distantForest/time_scheduler/documentation/ARCHITECTURE.tmp.md

# COMPONENT ARCHITECTURE

The **Time Scheduler** component manages the execution of functions according to a predefined time schedule. The component's functionality is shown in [Figure 1](#rec-spec-figure_1).

<!-- <div style="float:center" markdown="1"> -->

<!--  -->

<!-- |![](./media/functional-diagram.png "Time scheduler functional diagram")| -->
<!-- |---| -->
<!-- |*Figure 1. Time scheduler functional diagram.*| -->

<!-- </div> -->

  <a name="rec-spec-figure_1">
 <figure>
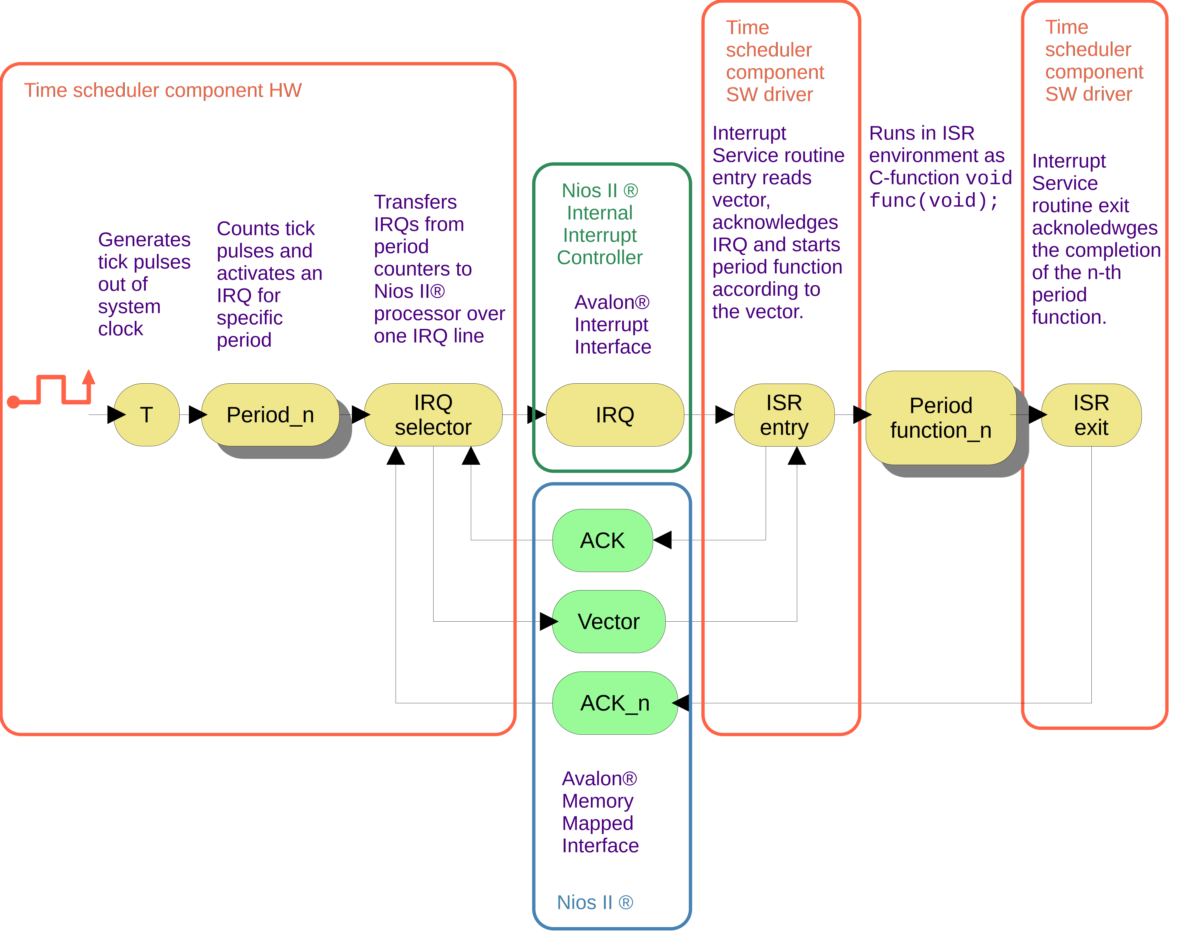
[picture p1: documentation/media/functional-diagram.png]
Functional diagram
  
  <figcaption>Figure 1. Time scheduler functional diagram.</figcaption>
</figure> 
  </a>

The functionality of the component is described as follows:

* The tick function (shown as **T** in the diagram) generates a tick signal derived from the system clock.

* This tick signal is distributed to a set of period counters. Each period counter counts tick pulses up to a specified period limit, which is individually defined for each counter. When a counter reaches its period limit, it asserts its own interrupt request (IRQ), sent to the IRQ selector.

* The **IRQ selector** handles individual period IRQs and multiplexes them over a single shared interrupt line (Avalon® Interrupt Interface) to the Nios II® processor. A simple priority scheme is used while multiplexing the individual IRQs. The IRQ selector uses acknowledge signals and a vector parameter for multiplexing and prioritizing individual IRQs. These signals are transferred via the Avalon® Memory-Mapped Interface.

* The **Interrupt Service Routine (ISR)** reads the vector and acknowledges that the IRQ line is free. It then calls the corresponding period function based on the vector. Upon completion, the ISR acknowledges the completion of the period function execution.

## Hardware architecture.

The hardware module architecture is shown on [Figure 2](#fig-hw-arc).
<!-- <div style="float:center" markdown="1"> -->

<!-- |![](./media/time-scheduler-HW-architecture.png "Time scheduler hardware architecture diagram")| -->
<!-- |:---:| -->
<!-- |*Figure 2. Time scheduler hardware module architecture.*| -->

<!-- </div> -->

<!--  -->
  <a name="fig-hw-arc">
<figure>
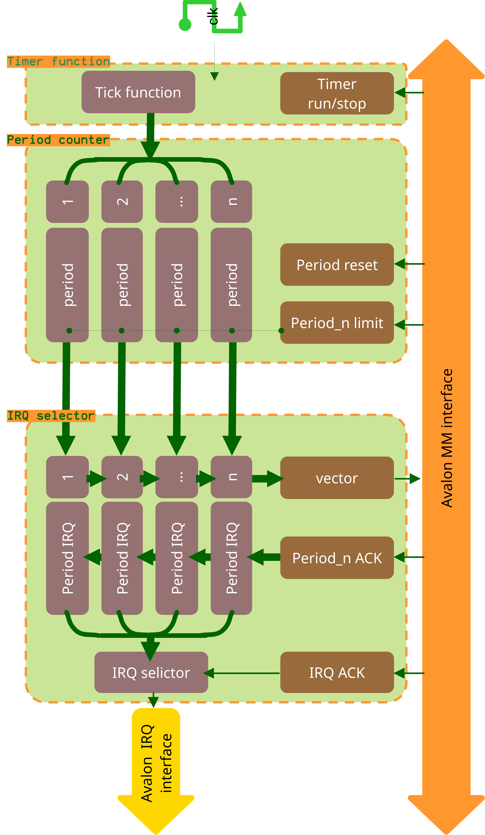
[picture p2: documentation/media/time-scheduler-HW-architecture.png]
Time scheduler hardware architecture diagram
    
    <figcaption>Figure 2. Time scheduler hardware architecture diagram.</figcaption>
</figure> 
  </a>

The hardware module is connected to the Avalon bus and is controlled via a set of registers. The hardware module consists of three blocks. Each block has control/data registers connected to the Avalon Memory-Mapped interface. All the registers are available for the software running on the Nios II processor connected to the Avalon bus. The blocks that constitute the hardware module are:

* **Timer function**. This block generates tick pulses. The tick pulse period is configured in the hardware synthesis phase. The tick function can be started and stopped via a register.
* **Period counter**. This block contains a set of tick pulse counters. The number of counters is defined in the hardware synthesis phase. The period limits can be set individually in the hardware synthesis phase and via registers as well. The period counters feed the generated IRQ to the IRQ selector block.
* **IRQ selector**. This block manages the individually generated period IRQs over a single interrupt line. The IRQ selector uses the period index as a vector. The IRQ selector expects an acknowledgment for IRQ taking and an acknowledgment for period function completion. The period index represents the priority of the period. Priority 0 is the highest. The lower the period index, the higher the priority.

### Tick function.

<!-- <div> -->

<!--  -->
<!-- ![](./media/tick_function.png "Tick function block symbol") -->
<!-- <figcaption>Figure 8. Tick function block symbol.</br></br></br></figcaption> -->

<!-- </div> -->
The `tick_function` block is defined in the file `tick_timer.vhd`. The tick function block symbol is shown in [Figure 3](#fig-3-tick-symbol).

<figure>
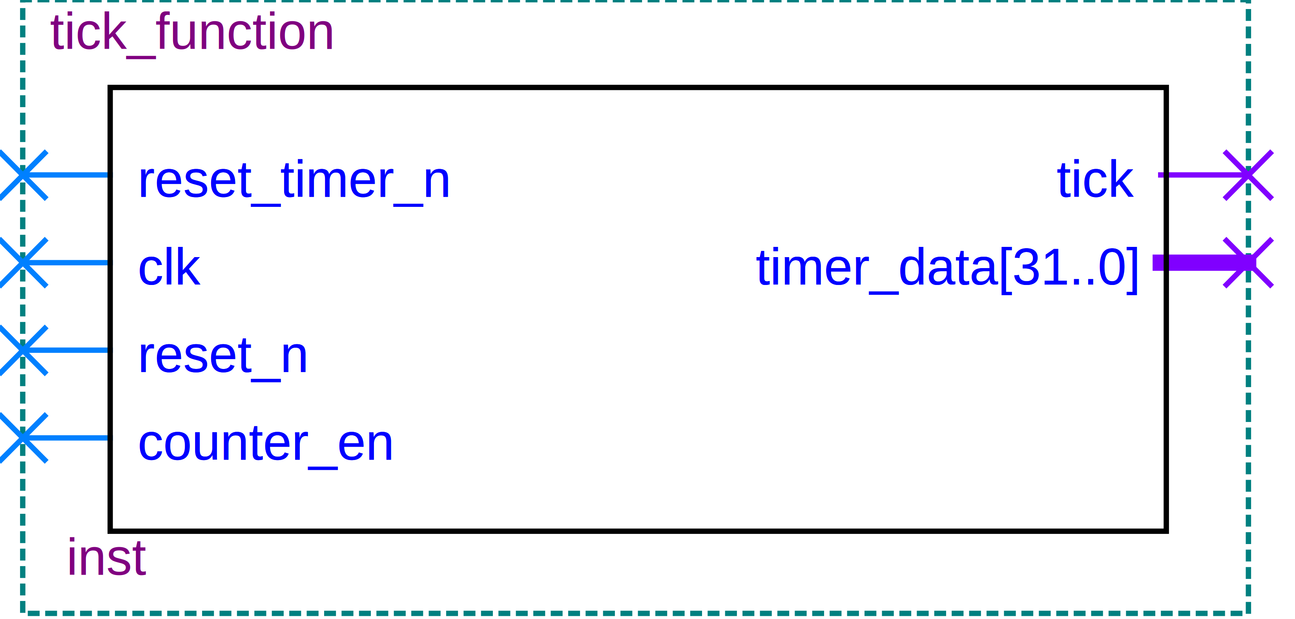
[picture p3: documentation/media/tick_function.png]
Tick function block symbol
  
  <figcaption>Figure 3. Tick function block symbol.</figcaption>
</figure> 

The tick function is based on a counter that counts system clock pulses up to the `tick_length` parameter. It holds its output high during the first half of the interval and low during the second half, forming a square wave with a period equal to `tick_length`.
[Figure 4](#fig-4-tick-arch) shows the architecture of the tick function.

<!-- <div> -->

<!--  -->
<!-- ![](./media/tick_function_rtl.png "Tick function architecture") -->
<!-- <caption>Figure 8. Tick function architecture.</br></br></br></caption> -->

<!-- </div> -->

<figure>
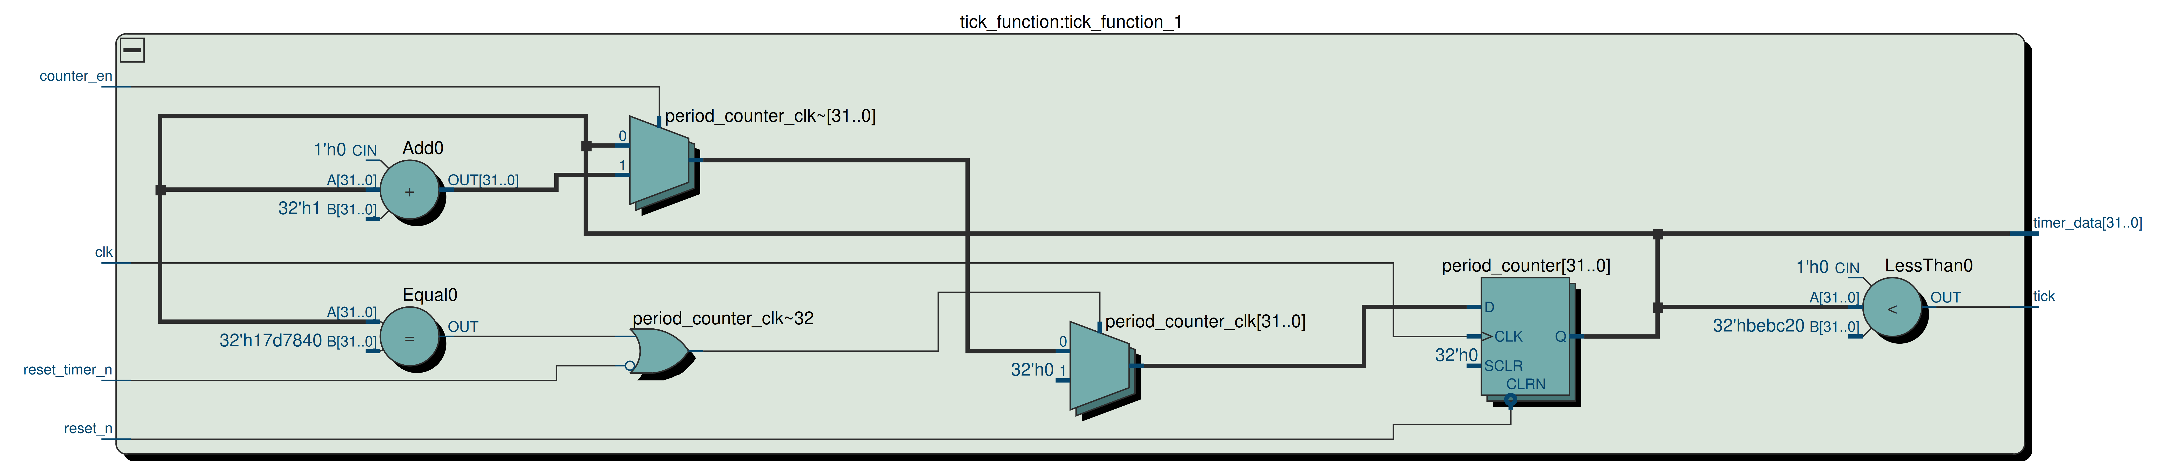
[picture p4: documentation/media/tick_function_rtl.png]
Tick function architecture
  
  <figcaption>Figure 4. Tick function architecture.</figcaption>
</figure> 

For debugging purposes, the tick function outputs a current value of its internal counter.

### IRQ selector.

The IRQ selector block transfers multiple IRQ requests from the period counters to the Nios II processor over a single IRQ line. The [Figure 5](#fig-5-irq-symbol) shows the IRQ selector block symbol.
<!-- <div> -->

<!--  -->
<!-- ![](./media/irq_selector.png "IRQ selector block symbol.") -->
<!-- <caption>Figure 9. IRQ selector block symbol.</br></br></br></caption> -->

<!-- </div> -->

<figure>
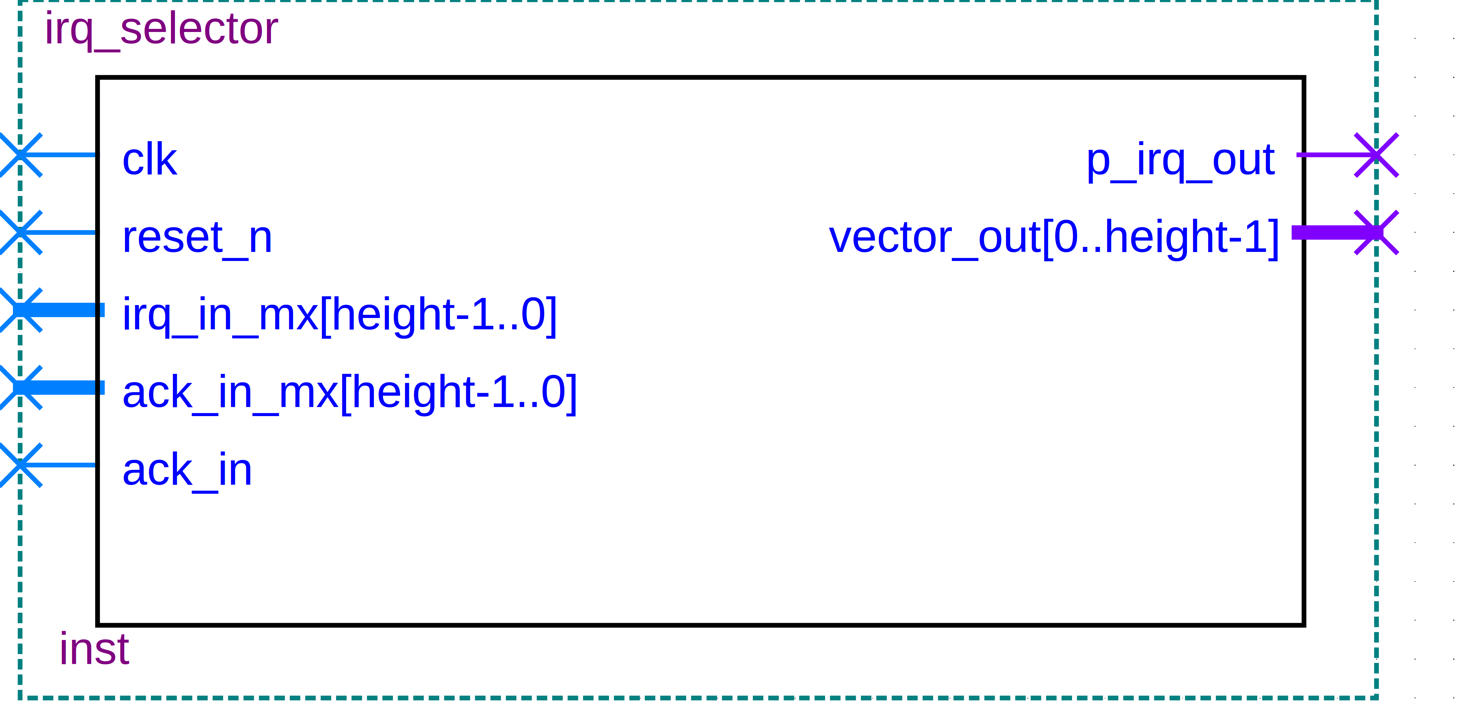
[picture p5: documentation/media/irq_selector.png]
IRQ selector block symbol
  
  <figcaption>Figure 5. IRQ selector block symbol.</figcaption>
</figure> 

The input signals:

* `clk`,`reset_n` - system clock and reset signals.
* `irq_in_mx` - `std_logic_vector` of IRQs from the period counters. A bit in the `irq_in_mx` corresponds to its period counter. A bit in the vector is set to `1` when corresponding period counter reaches its limit. A bit in the vector is cleared to `0` when corresponding period function is completed.
* `ack_in_mx` - acknowlege signals, indicating completion of a period function. Each bit corresponds to a period function.
* `ack_in` - acknowlege signal, indicating that the interrupt is taken by the ISR and the IRQ line is free. The IRQ selector then begins to process the next interrupt according to its priority strategy.

The output signals:

* `p_irq_out` - output IRQ line to Nios II processor.
* `vector_out` - interrupt `vector` as integer, showing the index of the period, being processed.
The architecture of the IRQ selector is shown in [Figure 6](#fig-6-irq-arch).

<!-- <div> -->

<!--  -->
<!-- ![](./media/irq_selector_rtl.png "IRQ selector architecture.") -->
<!-- <caption>Figure 9. IRQ selector architecture.</br></br></br></caption> -->

<!-- </div> -->

<figure>
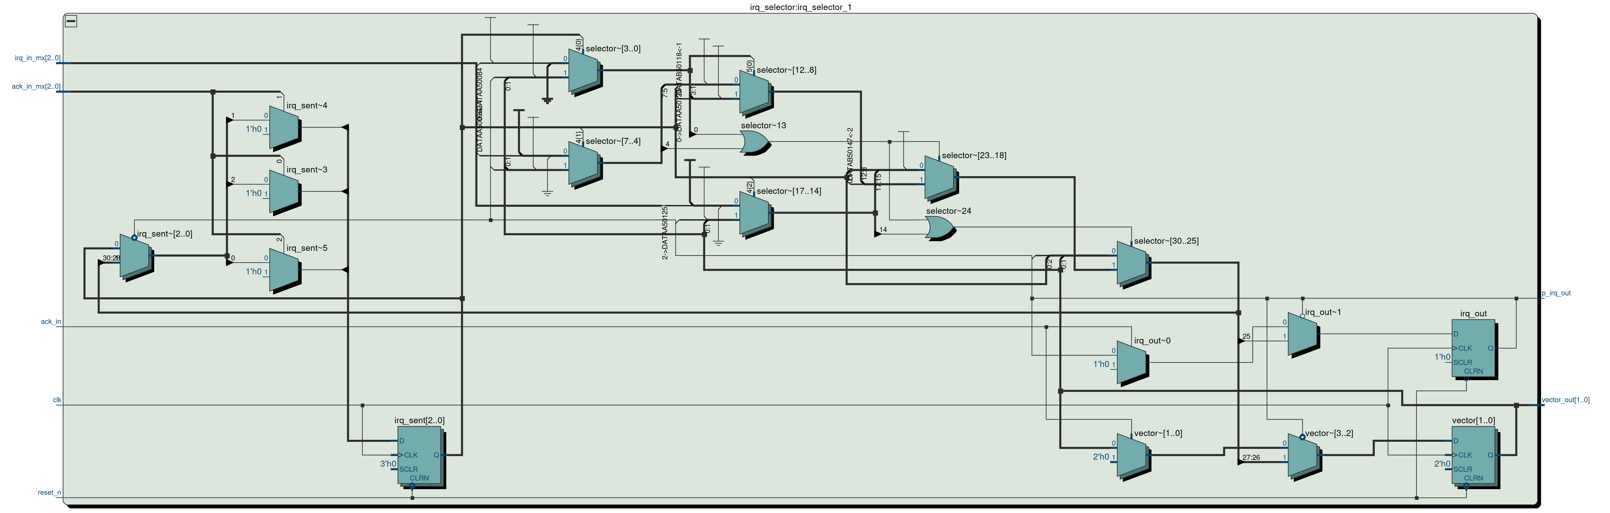
[picture p6: documentation/media/irq_selector_rtl.png]
IRQ selector architecture
  
  <figcaption>Figure 6. IRQ selector architecture.</figcaption>
</figure> 

The Platform Designer synthesises a IRQ selector block according to the `counter_hight` parameter. Therefore, the dimensions of the registers and the connecting logic can vary.

#### IRQ Prioritization and Preemption

The IRQ selector block implements a simple strategy for prioritizing and preempting period IRQs. It begins processing when the IRQ line becomes free and new IRQs have arrived. Among them, it processes the one with the lowest period number, but only if that number is lower than any currently pending IRQ. By doing this, it preempts lower-priority pending IRQs.

##### Step-by-step logic:

1. Is IRQ line free?
   - if yes, continue to next step.
   - if no, exit.
2. Check for newly arrived period IRQs.
3. If there are no new IRQs, exit.
4. If there are:
   - Find the newly arrived IRQ with the lowest number.
   - Compare this number to all pending IRQs.
5. If the new IRQ's number is lower than any pending IRQ:
   - Process this IRQ; exit
6. Otherwise:
   - Do not process the new IRQ; exit.
   
### Period Counter.

The Period Counter block takes the `tick_front` signal as input and counts the ticks in a number of counters. The count limits for the counters are provided by the signal `period_length`. When a counter reaches its corresponded limit it sets a bit (according to the counter number) in the `p_counter_irq` register.

The [Figure 7](#fig-7-counter-symbol) shows the block symbol of the Period Counter block. 

<a name="fig-7-counter-symbol">
<figure>
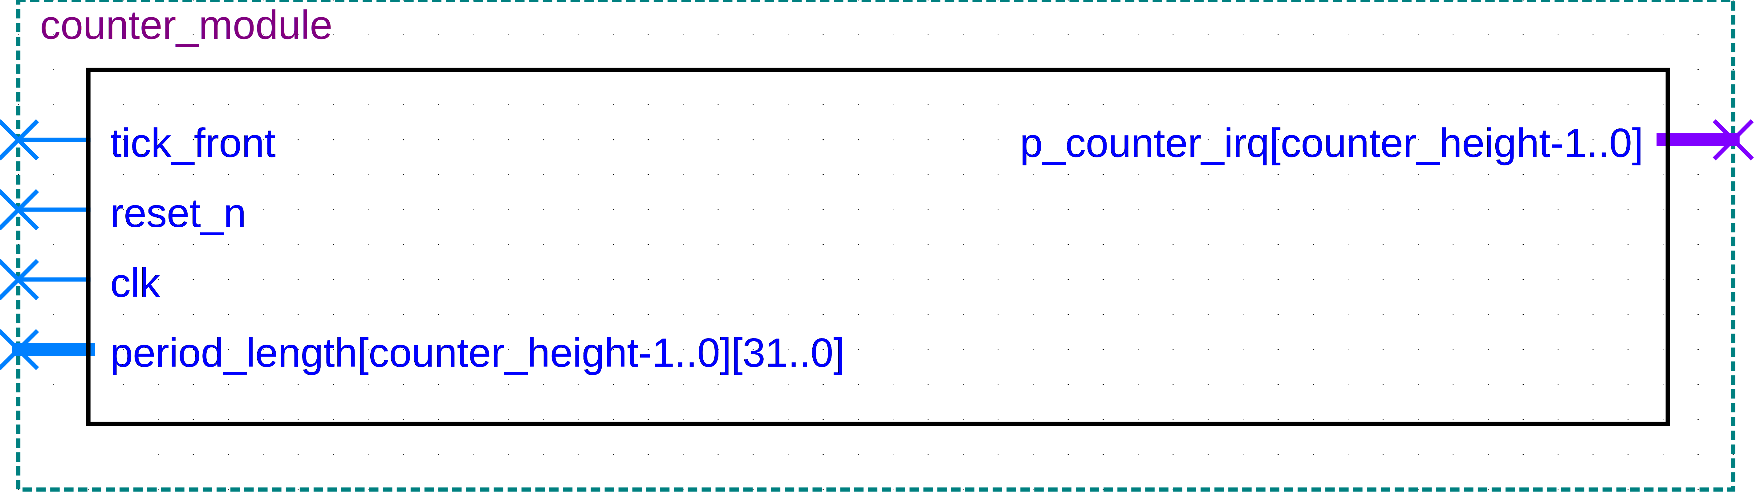
[picture p7: documentation/media/counter_module_symbol.png]
Period Counter block symbol
  
  <figcaption>Figure 7. Period Counter block symbol.</figcaption>
</figure> 
</a>

The architecture of the Period Counter block is shown in the Figure 8.

<a name="fig-8">
<figure>
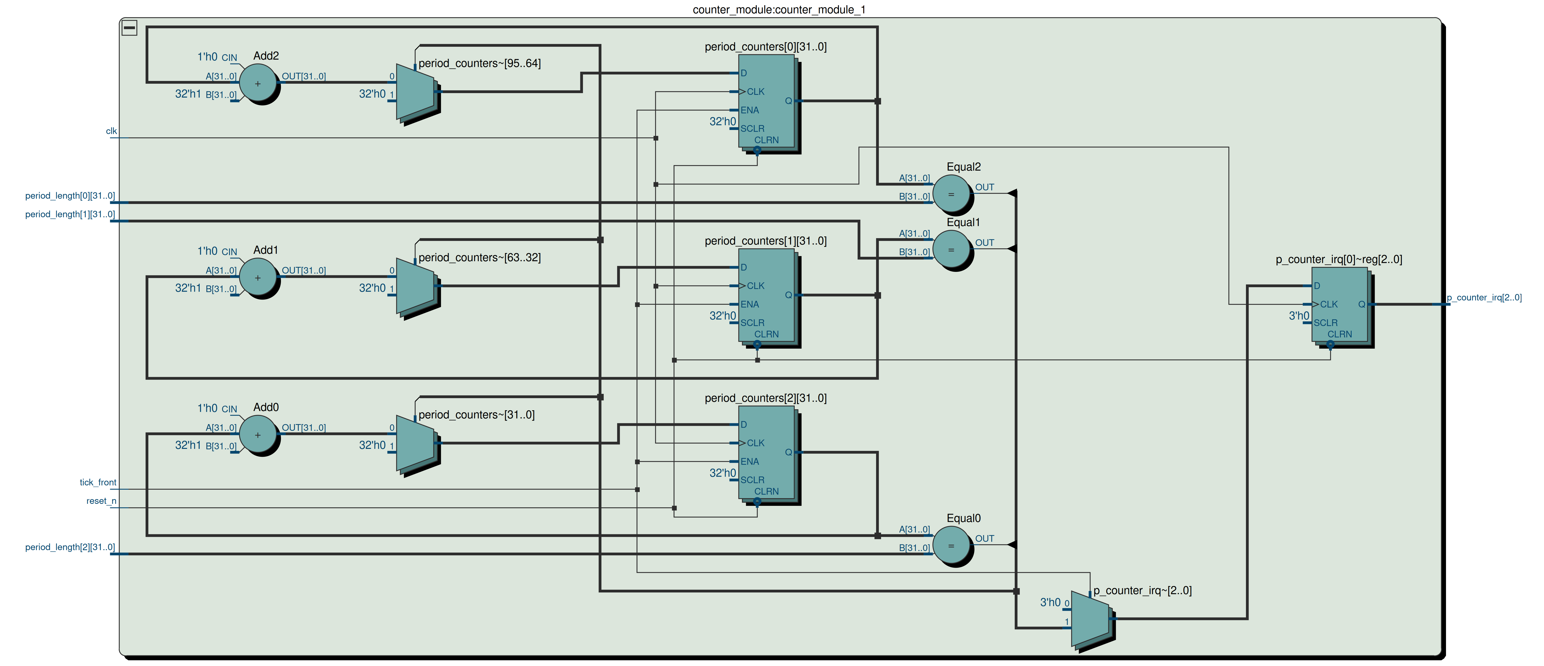
[picture p8: documentation/media/counter_module.png]
Period Counter architecture diagram
  
  <figcaption>Figure 8. Period Counter architecture diagram.</figcaption>
</figure> 
</a>

The Period Counter block is synthesised by the Platform Designer, therefore the bit width of the signals and the registers will be changed according to the `counter_height` parameter.

### Top-level module

The top-level module forms the time scheduler device ready to connect to Avalon bus and Nios II processor. The block symbol of the module is shown on the figure 9. 

<a name="fig-9">
<figure>
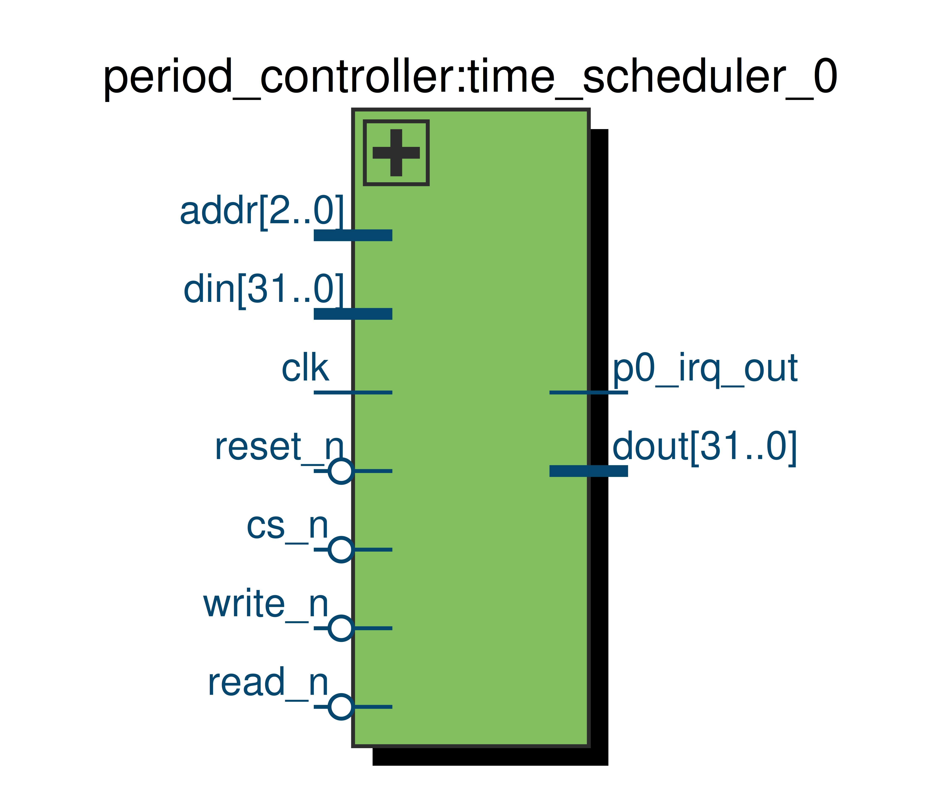
[picture p9: documentation/media/top_level_module.png]
Top-level module block symbol
  
  <figcaption>Figure 9. Top-level module block symbol.</figcaption>
</figure> 
</a>

Besides the blocks:
  * Period counter,
  * IRQ selector,
  * Tick timer
the Top-level module includes:
  * register interface logic,
  * the IRQ processing with the IRQ acknowledge logic,
  * the `counter_limits` registers.

## Software architecture ##

The software driver of the **Time Scheduler** component is designed to be included in a **Board Support Package** (BSP). The component's software architecture is shown in [Figure 10](#fig-sw-arc).

<figure>
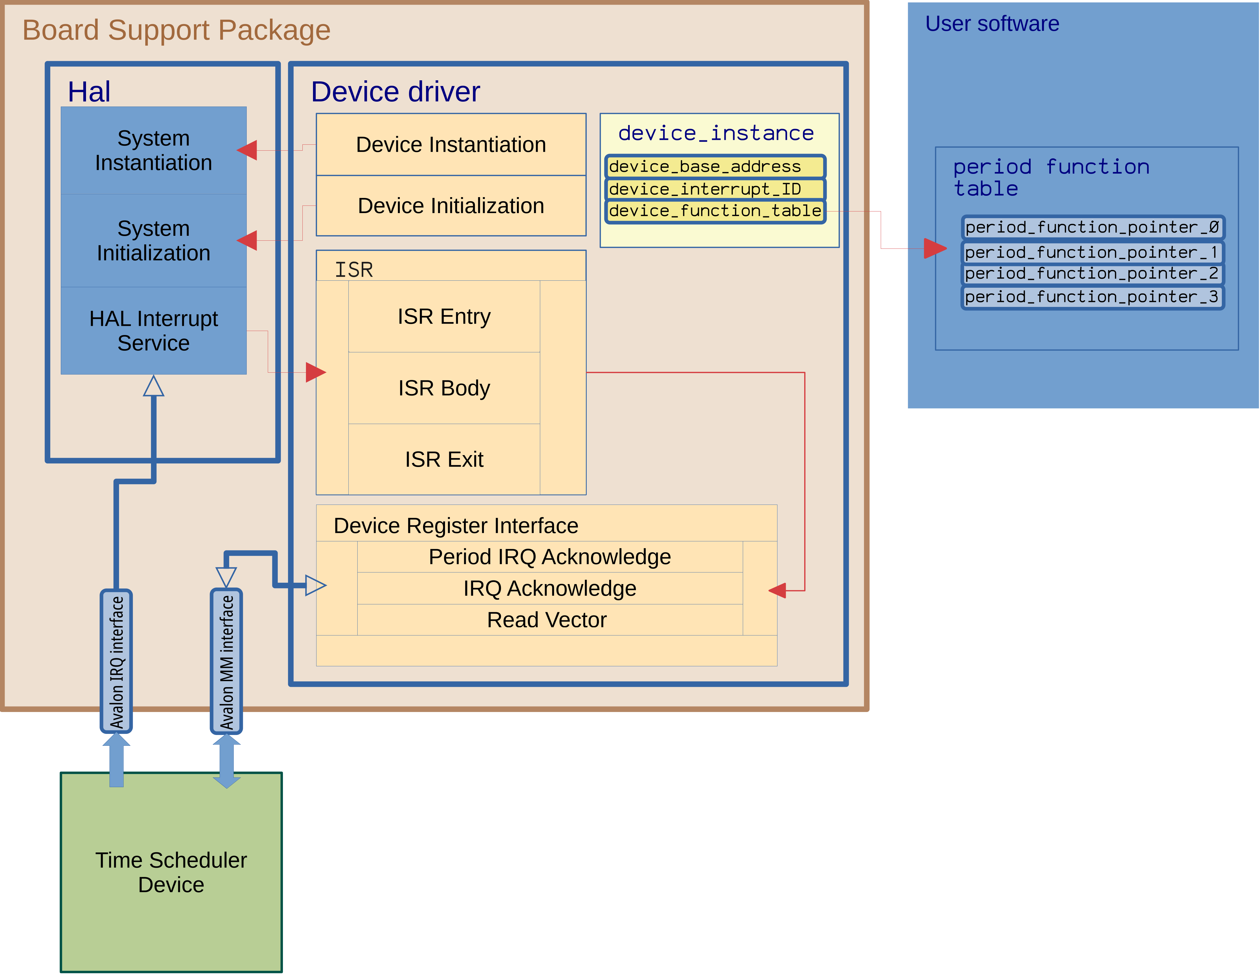
[picture p10: documentation/media/time-scheduler-SW-architecture.png]
Time scheduler software architecture diagram
  
  <figcaption>Figure 10. Time scheduler hardware architecture diagram.</figcaption>
</figure> 

The device driver includes the following:

* **Device Instantiation** and **Device Initialization** blocks. HAL (Hardware Abstraction Layer) uses these blocks to construct the system startup section.
  The *Device Instantiation* block creates a device instance for each Time Scheduler device present in the system.
  The *Device Initialization* block performs initial setup and configuration of each Time Scheduler device present in the system.
These blocks are formed as preprocessor macros. 
* The **Interrupt Service Routine (ISR)** interacts with the Time Scheduler device through the *Device Register Interface*.
  The ISR receives a pointer to the device instance (requiring service) as an input parameter.
  Each device instance includes a pointer to a period function table, which is provided by the user software for each Time Scheduler device present in the system. The ISR consist of three sections:
  1. Entry section. This section begins in interrupts disabled mode. The ISR reads and saves the `vector` from the Time Scheduler component, saves the device instance in its stack. Then, the ISR enables interrupts from the Time Scheduler component which it serves (according the saved device instance).
  2. The ISR body section. The Period Function Table is checked if it is not empty. If the table contains a pointer to a period function, the ISR calls it.
  3. The ISR exit section. By the period function return (called in the ISR body section) the ISR re-disables interrupts and returns to the HAL.

* The **Device Register Interface** provides access to the Time Scheduler device referenced by the corresponding device instance. It is represented as macros for reading and writing the registers of the Time Scheduler component.

A User needs to provide a Period Function Table. In case the period function table is not defined the Time Scheduler component remains inactive. The period function table can be defined at compile time by a macro, that the device driver provided. 
	
# COMPONENT CONFIGURATION. #

The configuration of the **Time Scheduler** component is defined in three stages:

* During system creation using the **Platform Designer** tool in Intel® Quartus® Prime Software
* During software development using the **Nios® II Embedded Design Suite (EDS)**
* At runtime via the **Device Register Interface**, during system initialization and/or by user software

The Time Scheduler component is packaged as an IP component for the Platform Designer tool. In the tool, it is referenced as `agstu_time_scheduler`. The file structure of the IP component is shown in Figure 11.

<!-- <div style="float:center" markdown="1"> -->

<!--  -->

<!-- |![](./media/file-structure-ip.png "Time scheduler IP file structure")| -->
<!-- |:---:| -->
<!-- |*Figure 6. Time scheduler IP file structure.*| -->

<!-- </div> -->

<!--  -->

<!-- ![](./media/file-structure-ip.png "Time scheduler IP file structure") -->

<!-- <caption>Figure 6. Time scheduler IP file structure.</br></br></br></br></caption> -->

<!-- </div> -->

<figure>
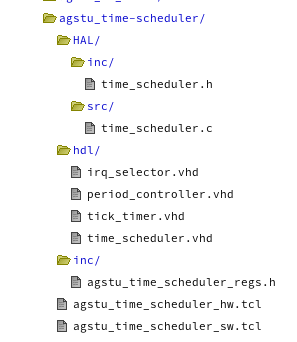
[picture p11: documentation/media/file-structure-ip.png]
Time scheduler IP file structure
  
  <figcaption>Figure 11. Time scheduler scheduler IP file structure.</figcaption>
</figure> 

The default time schedule is defined during creation of the target system with Platform Designer tool. The following parameters  defined in this phase:

* **Tick pulse period** – This parameter can only be configured in the Platform Designer tool.
* **Number of periods** – This parameter can only be configured in the Platform Designer tool.
* **Initial period limit values** for each period – These parameters can be configured both in the Platform Designer tool and at runtime.

The configuration scheme is shown in Table 3.

<!-- | Parameter            | Description                                                             | Configured in:             | -->
<!-- |----------------------|-------------------------------------------------------------------------|----------------------------| -->
<!-- | `tick_length`        | tick pulse period                                                        | Platform Designer          | -->
<!-- | `counter_height`     | number of the periods in the system                                     | Platform Designer          | -->
<!-- | `period_limit`[0:15] | period limits for period counters                                       | Platform Designer, Runtime | -->
<!-- | period functions      | Period function pointers collected in a table (period function table);  provided to the driver by user software.| Preprocessor time, Runtime | -->
<!-- |                      |                                                                         |                            | -->

<table>
<caption>
Table 3. Component parameter configuration
</caption>
<colgroup>
<col style="width: 17%" />
<col style="width: 59%" />
<col style="width: 22%" />
</colgroup>
<thead>
<tr><th>Parameter</th><th>Description</th><th>Configured in:</th></tr>
</thead>
<tbody>
<tr>
<td><code>tick_length</code></td><td>tick pulse period</td><td>Platform Designer</td></tr>
<tr>
<td><code>counter_height</code></td><td>number of the periods in the system</td><td>Platform Designer</td>
</tr>
<tr><td><code>period_limit</code>[0:15]</td><td>period limits for period counters</td><td>Platform Designer, Runtime</td>
</tr>
<tr>
<td>period functions</td>
<td>Period function pointers collected in a table (period function table); provided to the driver by user software.</td>
<td>Preprocessor time, Runtime</td>
</tr>
<tr>
<td></td>
<td></td>
<td></td>
</tr>
</tbody>
</table>

## Configuration during system creation with Platform Designer tool.

An initial time schedule can be defined when the component is integrated into the target system. This is done in the **Parameters** window of the component. An example of the Parameters window is shown in [Figure 12](#fig-ip-parameter-window).

<!-- <div> -->

<!--  -->
<!-- ![](./media/configuration.png "Time scheduler IP Parameters window") -->
<!-- <caption>Figure 7. Time scheduler IP Parameters window.</br></br></br></caption> -->

<!-- </div> -->

<figure>
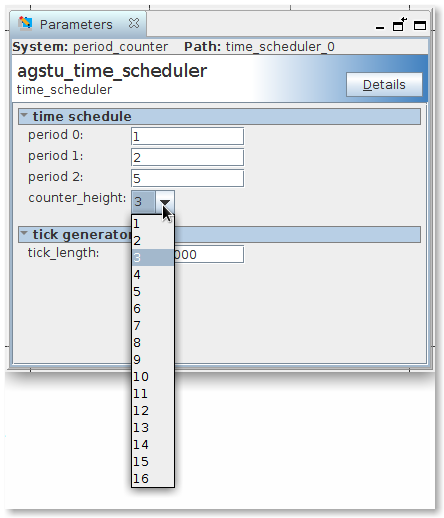
[picture p12: documentation/media/configuration.png]
Time scheduler IP Parameters window
  
  <figcaption>Figure 12. Time scheduler IP Parameters window.</figcaption>
</figure> 

The definitions of the parameters and the way they appear and behave in the Parameters window are specified in the `agstu_time_scheduler_sw.tcl` file. The `counter_height` and `tick_length` parameters are defined as integer values. Their definitions are similar and largely self-explanatory. As an example, the definition of `tick_length` is shown below:

``` tcl
add_parameter tick_length NATURAL 25000000 "tick pulse period length in system clock pulses"
set_parameter_property tick_length DEFAULT_VALUE 25000000
set_parameter_property tick_length DISPLAY_NAME tick_length
set_parameter_property tick_length TYPE NATURAL
set_parameter_property tick_length UNITS None
set_parameter_property tick_length ALLOWED_RANGES 3:0x7fffffff
set_parameter_property tick_length DESCRIPTION "tick pulse period length in system clock pulses"
set_parameter_property tick_length HDL_PARAMETER true
```

The parameters `per0` .. `per15` represent initial value for the period limits. These parameters are assigned as constant values in the HDL design of the time scheduler component.

The `counter_height` parameter is defined as a drop-down list as shown bellow:

``` tcl
add_parameter counter_height INTEGER 4 "The number of periods in the schedule"
set_parameter_property counter_height GROUP ""
set_parameter_property counter_height DEFAULT_VALUE 4
set_parameter_property counter_height DISPLAY_NAME counter_height
set_parameter_property counter_height WIDTH ""
set_parameter_property counter_height TYPE POSITIVE
set_parameter_property counter_height UNITS None
set_parameter_property counter_height ALLOWED_RANGES {
    1:1 2:2 3:3 4:4 5:5 6:6 7:7 8:8
    9:9 10:10 11:11 12:12 13:13
    14:14 15:15 16:16}
set_parameter_property counter_height DESCRIPTION "The number of periods in the schedule"
set_parameter_property counter_height HDL_PARAMETER true
``` 

The `HDL_PARAMETER` property ensures that the parameter value is assigned to the corresponding generic in the HDL design.

After the parameters are set in the Parameters window, the following adjustments are performed:

``` tcl
proc post_elaboration {} {
    set_module_assignment embeddedsw.CMacro.TICK_LENGTH \
	[get_parameter_value tick_length]

    set_module_assignment embeddedsw.CMacro.HEIGHT \
	[get_parameter_value counter_height]

    add_interface_port avalon_slave_0 addr address Input \
	[log2ceil [expr {[get_parameter_value counter_height] + 1 + 4}]]

}
```

By this procedure, the final values of `counter_height` and `tick_length`are passed to the BSP (Board Support Package), and the bit width of the address input is adjusted to accommodate four 32-bit control registers and, plus one 32-bit register for each period limit.

## Configuration with Nios® II Embedded Design Suite (EDS).

### Component configuration in software driver.

The software driver creates the following for each time scheduler component in the target system:

  * An instance, which represents a record containing information about the corresponding component, including:
    * base address
	* IRQ line
	* interrupt controller ID
	* pointer to a period function table.
  
  * An initialization procedure.

Both, the instance and the initialization procedure are implemented as macros. These macros are placed into the system initialization section during BSP generation. The pointer to a period function table sets to NULL during compilation of the BSP. If the user software does not provide a pointer to a period function table, the component remains inactive till the pointer is set at runtime.

User software defines a period function table. It is created during compilation of the user software. During linking the pointer to the period function table is assigned to the component instance. The period function table can be changed at runtime by the user software. The software driver provides a preprocessor macro for defining a period function table.
