distantForest/time_scheduler/documentation/media/hw_architecture.png

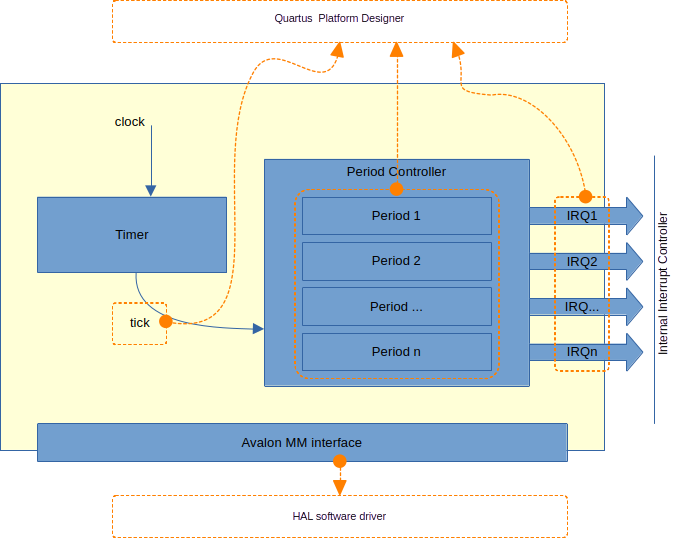
documentation/media/hw_architecture.png
