distantForest/time_scheduler/documentation/media/sw_architecture.png

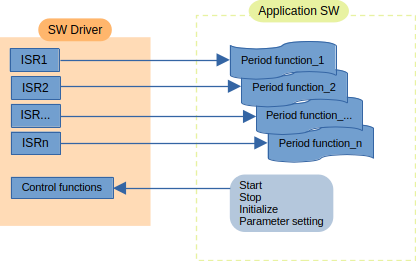
documentation/media/sw_architecture.png
