distantForest/time_scheduler/Project/period_counter/period_counter/period_counter_inst.vhd

	component period_counter is
		port (
			clk_clk       : in std_logic := 'X'; -- clk
			reset_reset_n : in std_logic := 'X'  -- reset_n
		);
	end component period_counter;

	u0 : component period_counter
		port map (
			clk_clk       => CONNECTED_TO_clk_clk,       --   clk.clk
			reset_reset_n => CONNECTED_TO_reset_reset_n  -- reset.reset_n
		);
