distantForest/time_scheduler/(commit log)

2025-01-22 interrupt logic added to period counter
2025-03-01 driver initial version
2025-03-11 Adjust period length from software, start/stop timer
2025-04-06 irq_ack puls generation corrected
    [period_controller.vhd, period_controller_tb.vhd]
2025-06-08 Makefile added, captions for pictures and tables fixed
    [period_controller.vhd]
2025-06-27 fixed sw driver comments
